S-k404/heater-driver-v4/reports/DRC_report.txt

** Drc report for heater_driver_v4.kicad_pcb **
** Created on 2026-10-17T09:11:54+0000 **
** Report includes: Errors, Warnings, Exclusions **

** Found 0 DRC violations **

** Found 0 unconnected pads **

** Found 0 Footprint errors **

** End of Report **
