S-k404/heater-driver-v4/docs/gerber_check_bottom.png

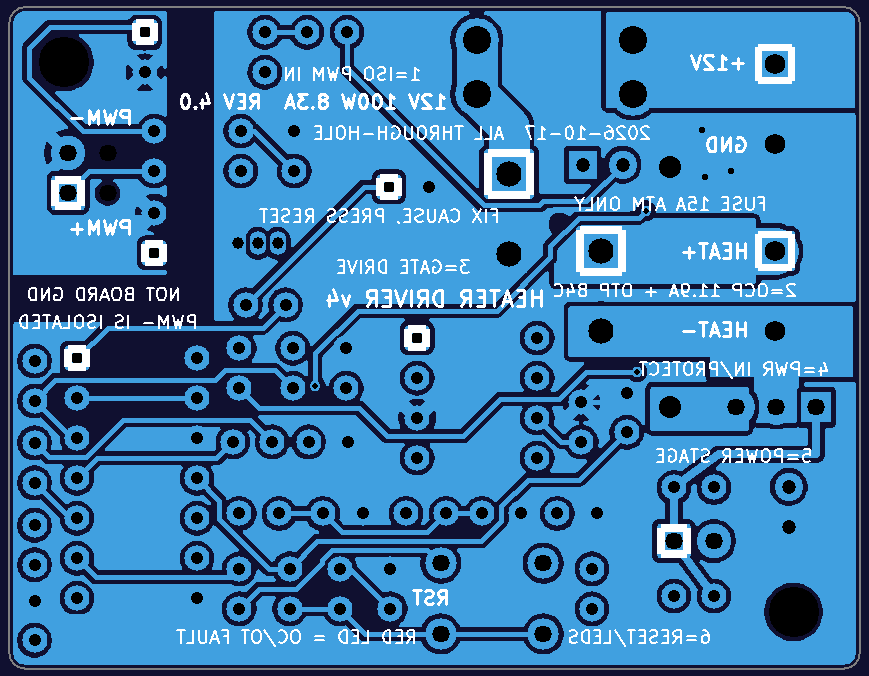
docs/gerber_check_bottom.png
