S-k404/heater-driver-v4/docs/gerber_check_top.png

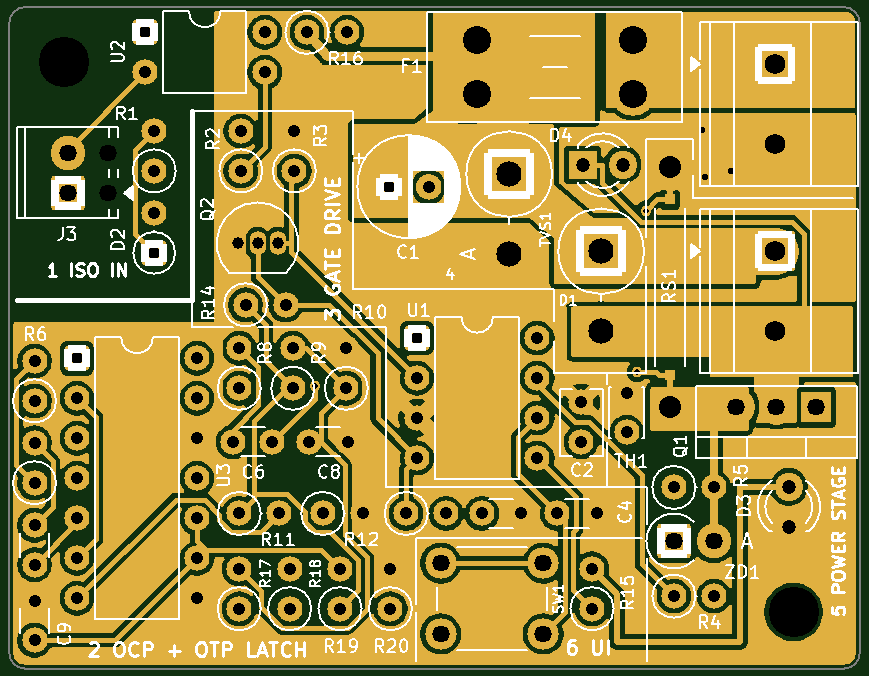
docs/gerber_check_top.png
