S-k404/heater-driver-v4/docs/heater_driver_v4_layout_bottom.png

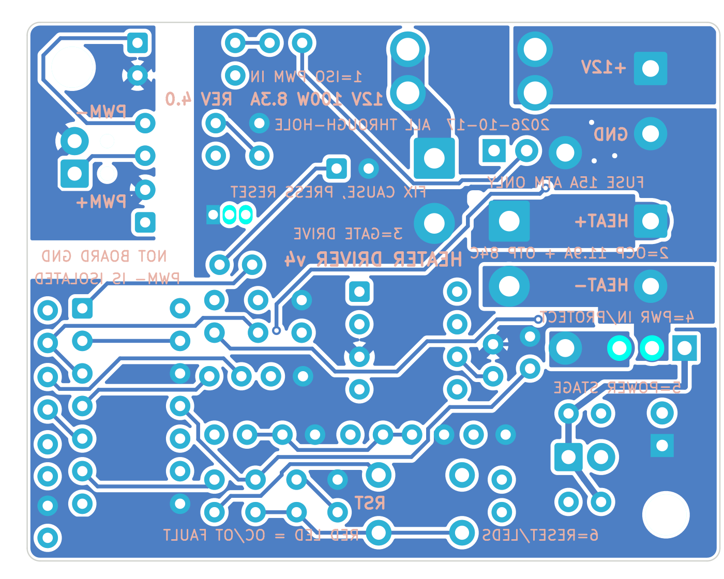
docs/heater_driver_v4_layout_bottom.png
