S-k404/heater-driver-v4/docs/heater_driver_v4_schematic.png

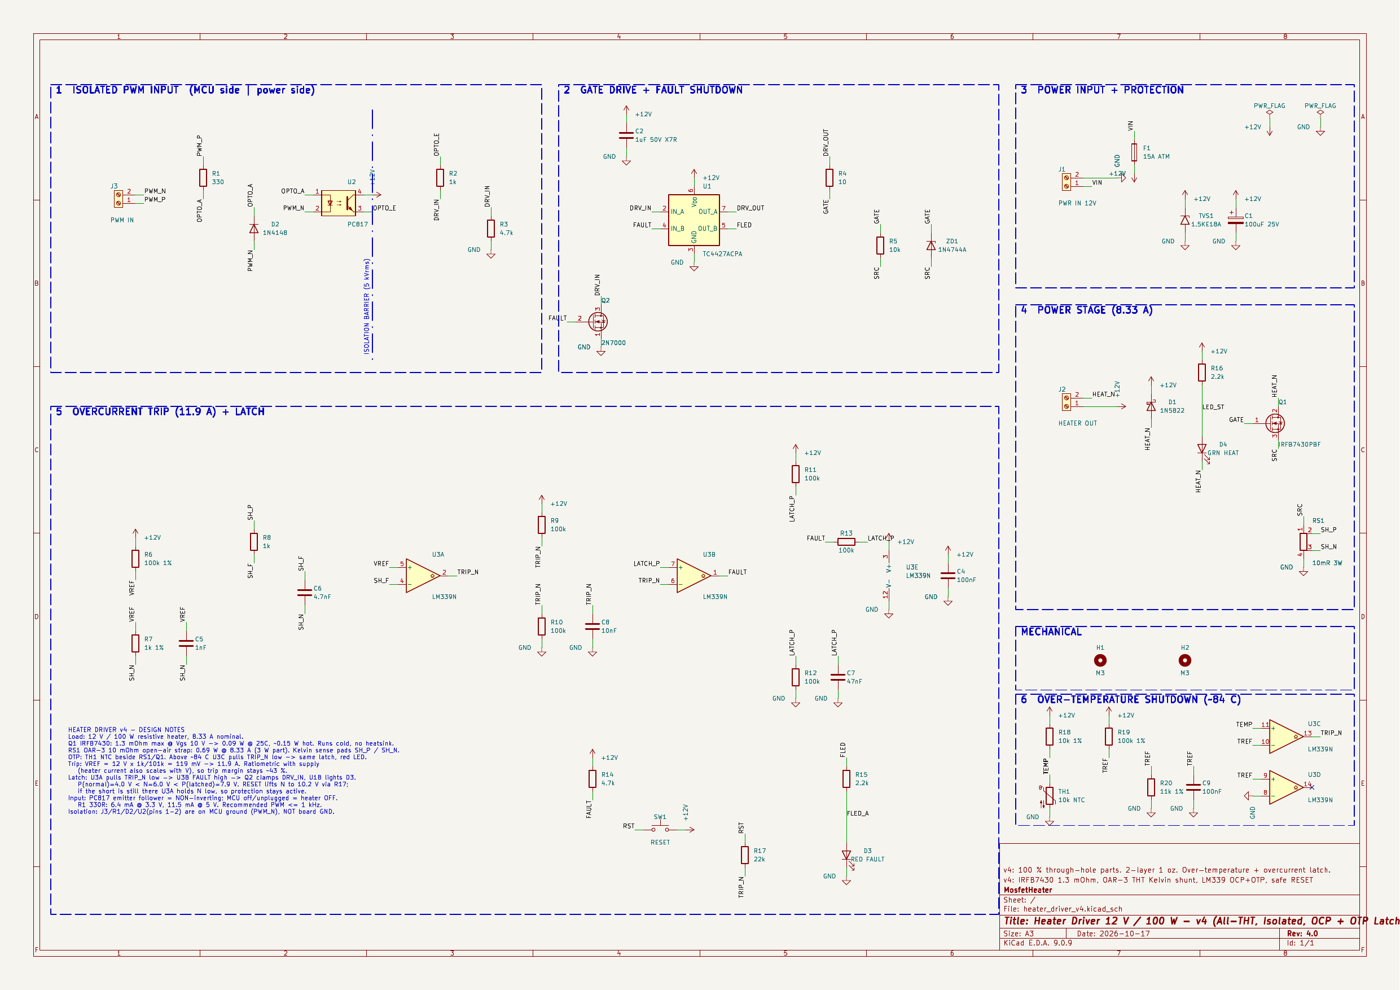
docs/heater_driver_v4_schematic.png
