S-k404/heater-driver-v4/sim/sim_overview.png

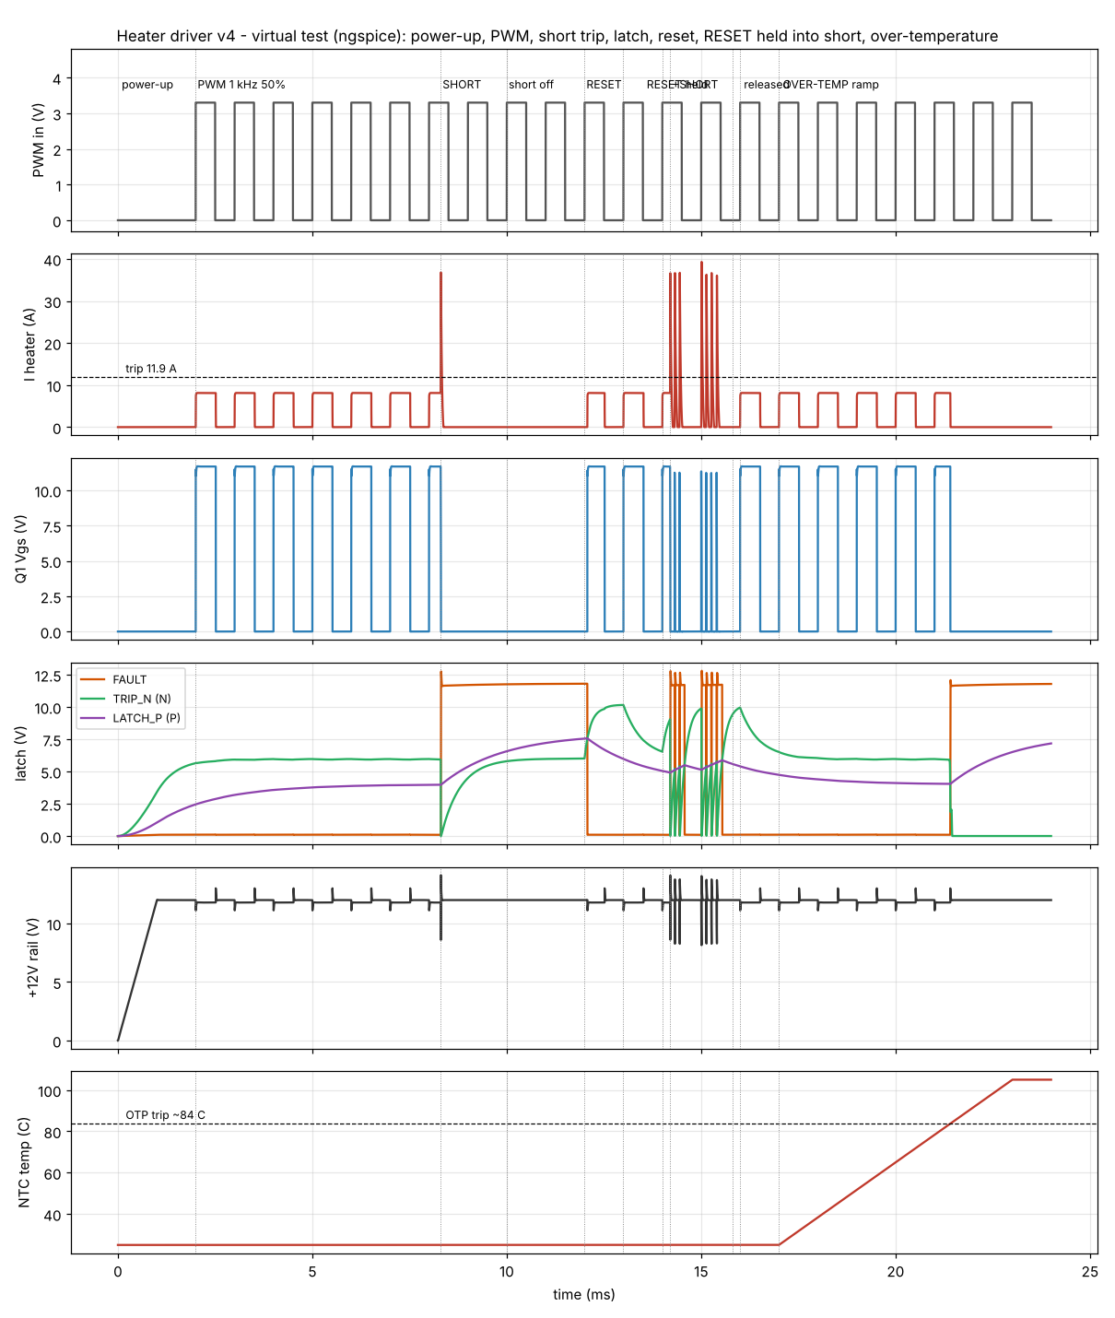
sim/sim_overview.png
