S-k404/heater-driver-v4/sim/sim_short_zoom.png

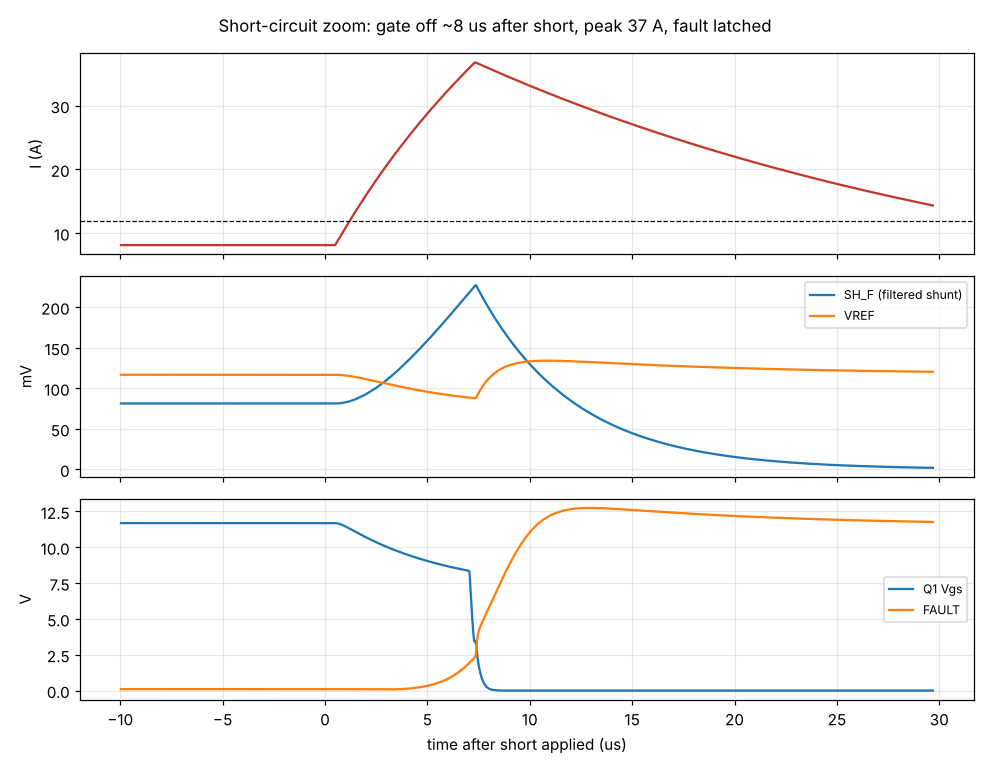
sim/sim_short_zoom.png
