S-k404/heater-driver-v4/bom/heater_driver_v4_BOM.csv

Reference | Value | Footprint | MPN | Description | Qty
C1 | 100uF 25V | Capacitor_THT:CP_Radial_D6.3mm_P2.50mm | Panasonic EEU-FR1E101 (low ESR, 6.3x11.2) | Bulk input capacitor | 1
C2 | 1uF 50V X7R | Capacitor_THT:C_Rect_L4.0mm_W2.5mm_P2.50mm | TDK FG28X7R1H105KRT06 | U1 decoupling (gate-charge reservoir) | 1
C4,C9 | 100nF | Capacitor_THT:C_Disc_D3.0mm_W1.6mm_P2.50mm | KEMET C320C104K5R5TA | Over-temp reference filter / soft start,U3 decoupling | 2
C5 | 1nF | Capacitor_THT:C_Disc_D3.0mm_W1.6mm_P2.50mm | KEMET C315C102K5R5TA | Reference HF filter | 1
C6 | 4.7nF | Capacitor_THT:C_Disc_D3.0mm_W1.6mm_P2.50mm | KEMET C315C472K5R5TA | Shunt sense filter C (4.7 us) | 1
C7 | 47nF | Capacitor_THT:C_Disc_D3.0mm_W1.6mm_P2.50mm | KEMET C320C473K5R5TA | Latch P timing / power-on reset (1.6 ms) | 1
C8 | 10nF | Capacitor_THT:C_Disc_D3.0mm_W1.6mm_P2.50mm | KEMET C315C103K5R5TA | Latch N timing (0.5 ms) | 1
D1 | 1N5822 | Diode_THT:D_DO-201AD_P5.08mm_Vertical_AnodeUp | onsemi 1N5822 | 40 V 3 A Schottky, heater flyback clamp | 1
D2 | 1N4148 | Diode_THT:D_DO-35_SOD27_P2.54mm_Vertical_AnodeUp | onsemi 1N4148 | Opto LED reverse-voltage protection | 1
D3 | RED FAULT | LED_THT:LED_D3.0mm | Kingbright WP7104ID | Red LED: overcurrent fault latched | 1
D4 | GRN HEAT | LED_THT:LED_D3.0mm | Kingbright WP7104GD | Green LED: heater ON | 1
F1 | 15A ATM | Fuse:Fuseholder_Blade_Mini_Keystone_3568 | Keystone 3568 + Littelfuse 0297015 (15A ATM) | Mini blade fuse holder + 15 A fuse | 1
J1 | PWR IN 12V | TerminalBlock_Phoenix:TerminalBlock_Phoenix_MKDS-1,5-2-5.08_1x02_P5.08mm_Horizontal | Phoenix 1729128 (MKDS 1,5/2-5,08, 13.5A) | Supply input screw terminal | 1
J2 | HEATER OUT | TerminalBlock_Phoenix:TerminalBlock_Phoenix_MKDS-1,5-2-5.08_1x02_P5.08mm_Horizontal | Phoenix 1729128 (MKDS 1,5/2-5,08, 13.5A) | Heater output screw terminal | 1
J3 | PWM IN | TerminalBlock_Phoenix:TerminalBlock_Phoenix_MPT-0,5-2-2.54_1x02_P2.54mm_Horizontal | Phoenix 1725656 (MPT 0,5/2-2,54) | Isolated PWM input (3.3-5 V logic) | 1
Q1 | IRFB7430PBF | Package_TO_SOT_THT:TO-220-3_Vertical | Infineon IRFB7430PBF (alt: IRLB3034PBF) | 40 V 195 A 1.3 mOhm N-MOSFET, low-side switch (~0.1 W at 8.3 A) | 1
Q2 | 2N7000 | Package_TO_SOT_THT:TO-92_Inline | onsemi 2N7000 | Fault shutdown: pulls driver input low | 1
R1 | 330 | Resistor_THT:R_Axial_DIN0207_L6.3mm_D2.5mm_P2.54mm_Vertical | Yageo MFR-25FBF52-330R | Opto LED current limit (6-11 mA) | 1
R2,R8 | 1k | Resistor_THT:R_Axial_DIN0207_L6.3mm_D2.5mm_P2.54mm_Vertical | Yageo MFR-25FBF52-1K | Opto emitter series resistor,Shunt sense filter R | 2
R3,R14 | 4.7k | Resistor_THT:R_Axial_DIN0207_L6.3mm_D2.5mm_P2.54mm_Vertical | Yageo MFR-25FBF52-4K7 | Driver input pull-down (fail-safe OFF),FAULT pull-up | 2
R4 | 10 | Resistor_THT:R_Axial_DIN0207_L6.3mm_D2.5mm_P2.54mm_Vertical | Yageo MFR-25FBF52-10R | Gate resistor | 1
R5 | 10k | Resistor_THT:R_Axial_DIN0207_L6.3mm_D2.5mm_P2.54mm_Vertical | Yageo MFR-25FBF52-10K | Gate-source pull-down | 1
R6,R19 | 100k 1% | Resistor_THT:R_Axial_DIN0207_L6.3mm_D2.5mm_P2.54mm_Vertical | Yageo MFR-25FBF52-100K | Over-temp reference divider (top),Trip reference divider (top) | 2
R7 | 1k 1% | Resistor_THT:R_Axial_DIN0207_L6.3mm_D2.5mm_P2.54mm_Vertical | Yageo MFR-25FBF52-1K | Trip reference divider (bottom): 119 mV = 11.9 A | 1
R9-R13 | 100k | Resistor_THT:R_Axial_DIN0207_L6.3mm_D2.5mm_P2.54mm_Vertical | Yageo MFR-25FBF52-100K | Latch P divider (bottom),Latch P divider (top),Latch positive feedback,Latch threshold divider (bottom),Latch threshold divider (top), N = 6 V | 5
R15,R16 | 2.2k | Resistor_THT:R_Axial_DIN0207_L6.3mm_D2.5mm_P2.54mm_Vertical | Yageo MFR-25FBF52-2K2 | FAULT LED resistor,HEAT ON LED resistor | 2
R17 | 22k | Resistor_THT:R_Axial_DIN0207_L6.3mm_D2.5mm_P2.54mm_Vertical | Yageo MFR-25FBF52-22K | Reset injection resistor: protection stays active while RESET is held | 1
R18 | 10k 1% | Resistor_THT:R_Axial_DIN0207_L6.3mm_D2.5mm_P2.54mm_Vertical | Yageo MFR-25FBF52-10K | NTC divider top | 1
R20 | 11k 1% | Resistor_THT:R_Axial_DIN0207_L6.3mm_D2.5mm_P2.54mm_Vertical | Yageo MFR-25FBF52-11K | Over-temp reference divider (bottom): 1.19 V = NTC 1.1k = ~84 C | 1
RS1 | 10mR 3W | HeaterDriver:R_Shunt_OAR3_P15.24mm_Kelvin | TT Electronics/IRC OAR3R010FLF | 10 mOhm 1% 3 W open-air THT current shunt, Kelvin sense pads | 1
SW1 | RESET | Button_Switch_THT:SW_PUSH_6mm | Omron B3F-1000 | Fault reset push-button (lifts TRIP_N above LATCH_P) | 1
TH1 | 10k NTC | Capacitor_THT:C_Disc_D3.0mm_W2.0mm_P2.50mm | Vishay NTCLE100E3103JB0 | NTC 10 k @25 C, B=3977: over-temperature sensor beside RS1/Q1 | 1
TVS1 | 1.5KE18A | Diode_THT:D_DO-201AD_P5.08mm_Vertical_AnodeUp | Littelfuse 1.5KE18A | 1500 W TVS, 15.3 V standoff | 1
U1 | TC4427ACPA | Package_DIP:DIP-8_W7.62mm | Microchip TC4427ACPA (DIP-8) | 1.5 A dual non-inverting MOSFET driver (A=gate, B=fault LED) | 1
U2 | PC817 | Package_DIP:DIP-4_W7.62mm | Sharp PC817X / Everlight EL817 | 5 kVrms optocoupler, non-inverting emitter-follower | 1
U3 | LM339N | Package_DIP:DIP-14_W7.62mm | TI LM339N (DIP-14) | Quad comparator: A=11.9 A trip, B=latch, C=over-temperature, D=spare | 1
ZD1 | 1N4744A | Diode_THT:D_DO-41_SOD81_P2.54mm_Vertical_AnodeUp | onsemi 1N4744A | 15 V 1 W zener gate clamp | 1
