S-k404/heater-driver-v4/docs/heater_driver_v4_schematic.pdf

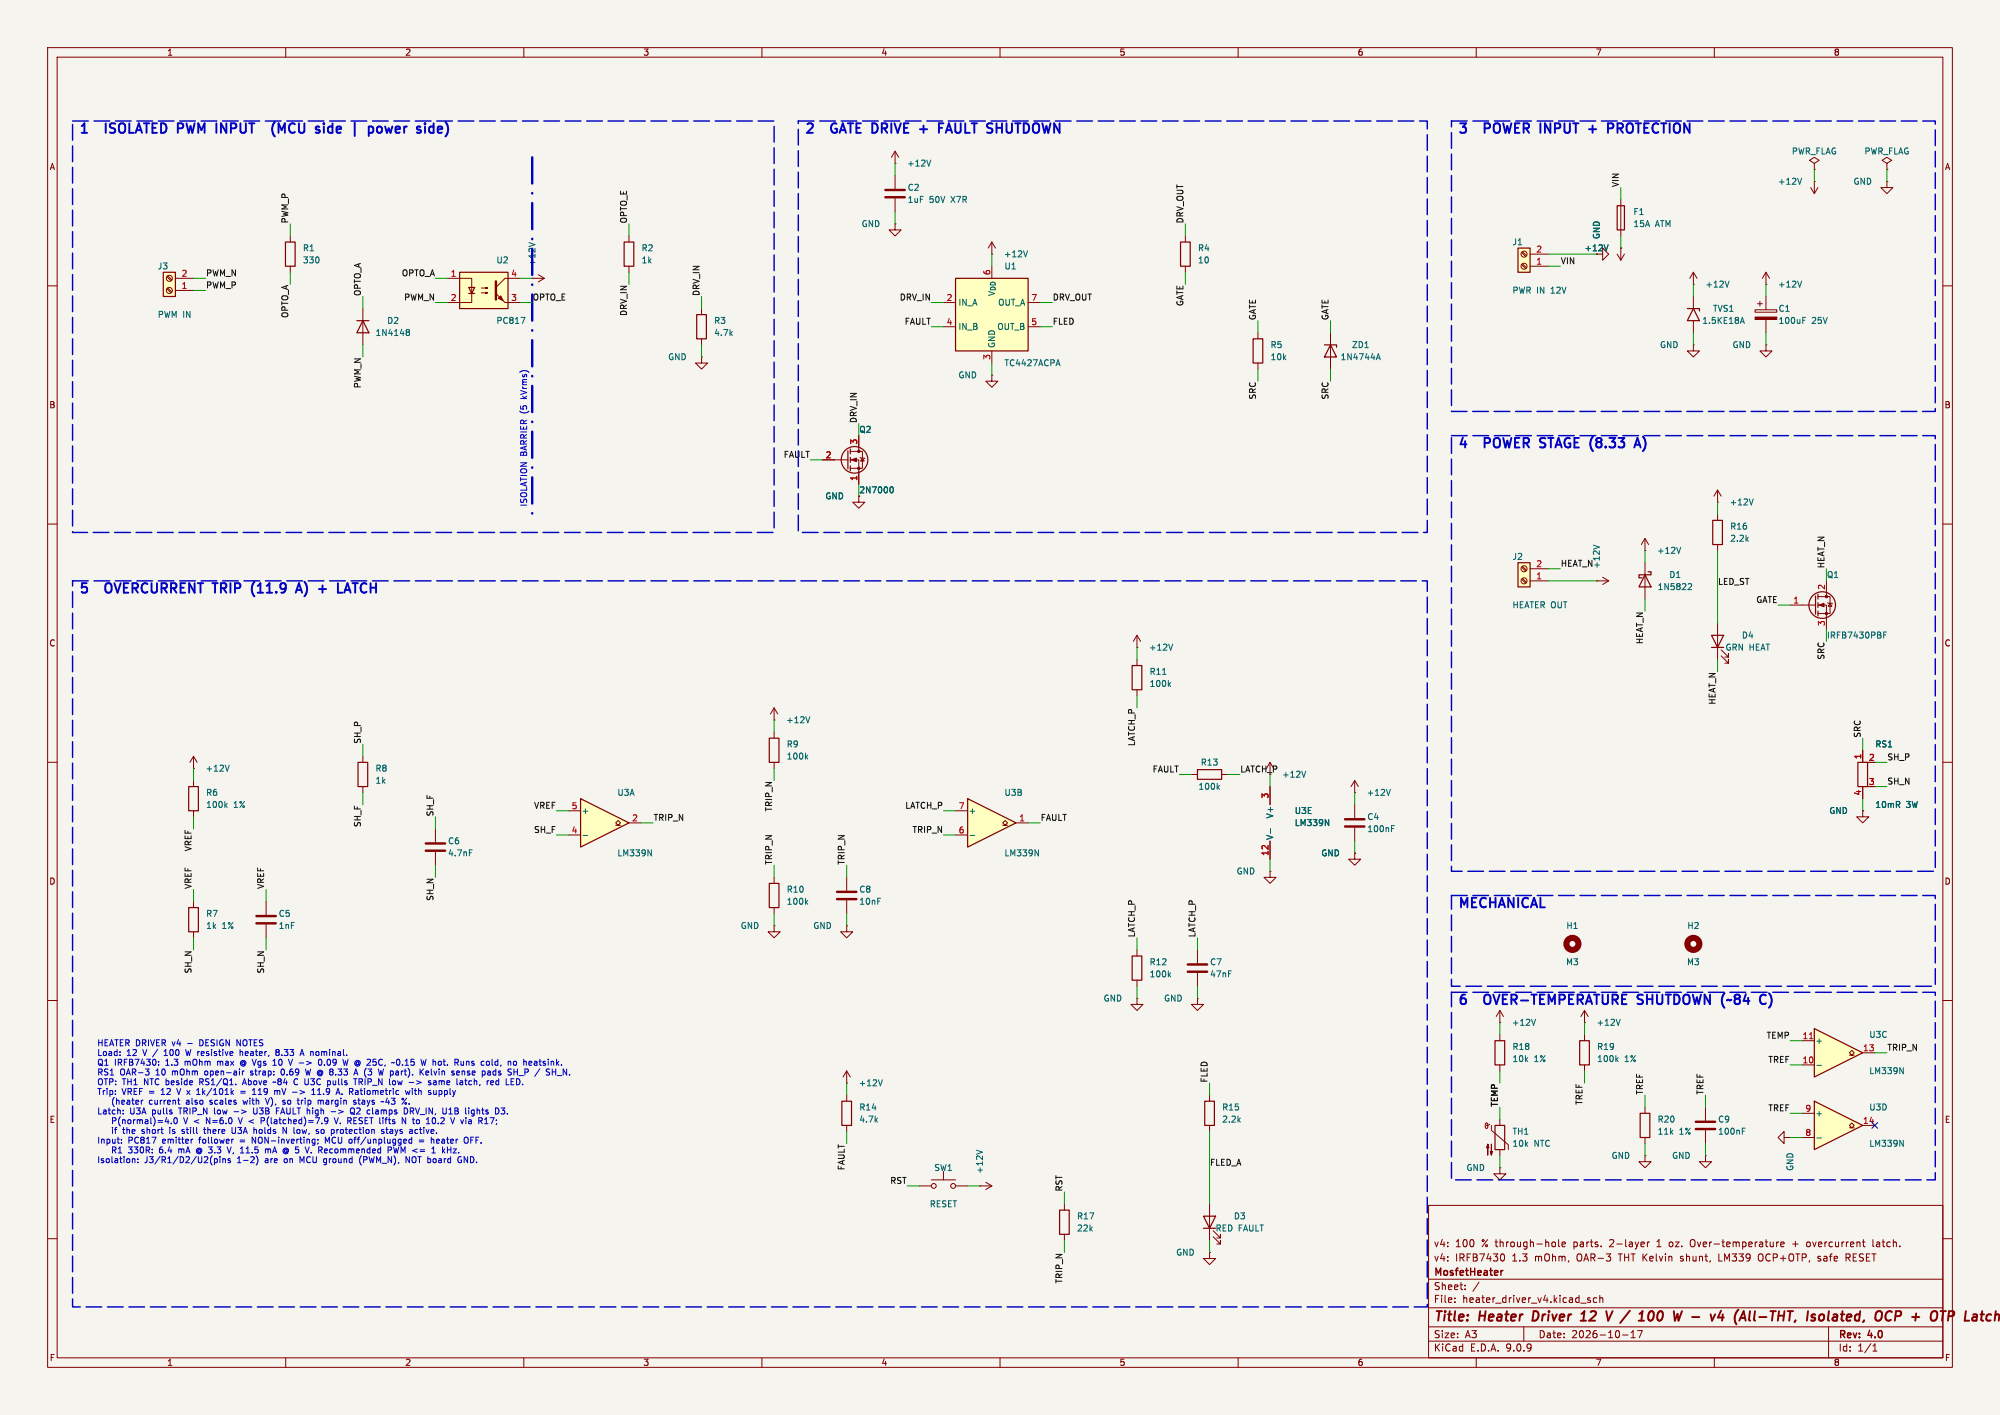
[picture p13: page 1]

HEATER DRIVER v4 - DESIGN NOTES
