S-k404/heater-driver-v4/docs/heater_driver_v4_layout.pdf

1 | 2 | 3 | 4 | 5 | 6

A

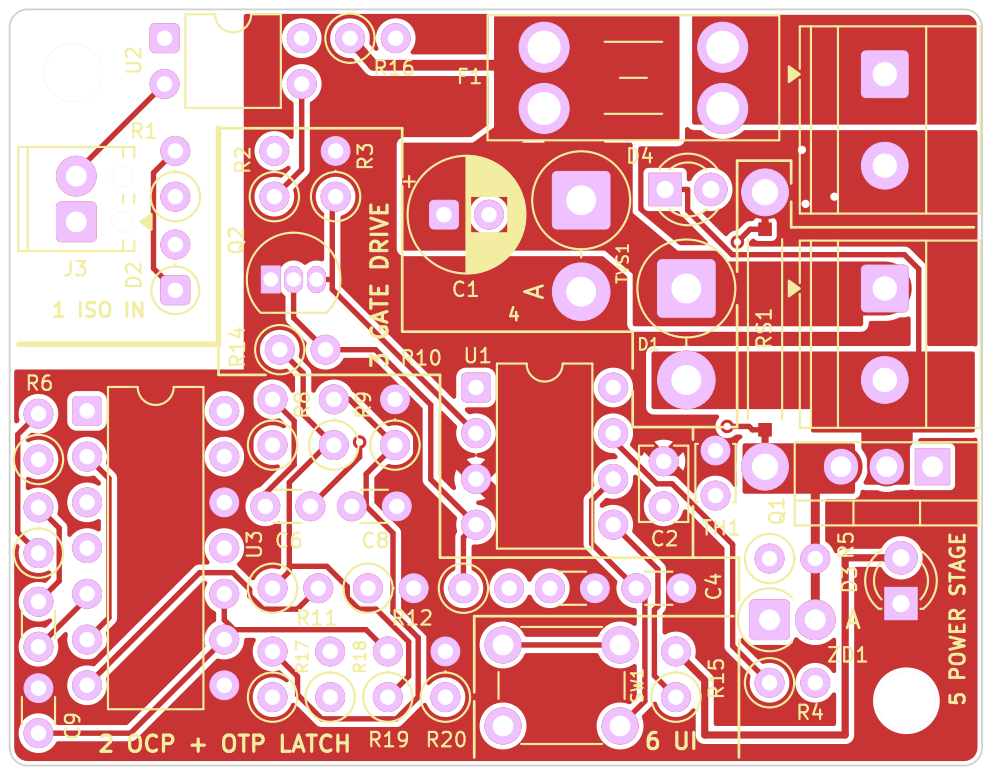
[picture p14: page 1]

Id: 1/1 Title: File: heater_driver_v4.kicad_pcb Sheet:

A

A

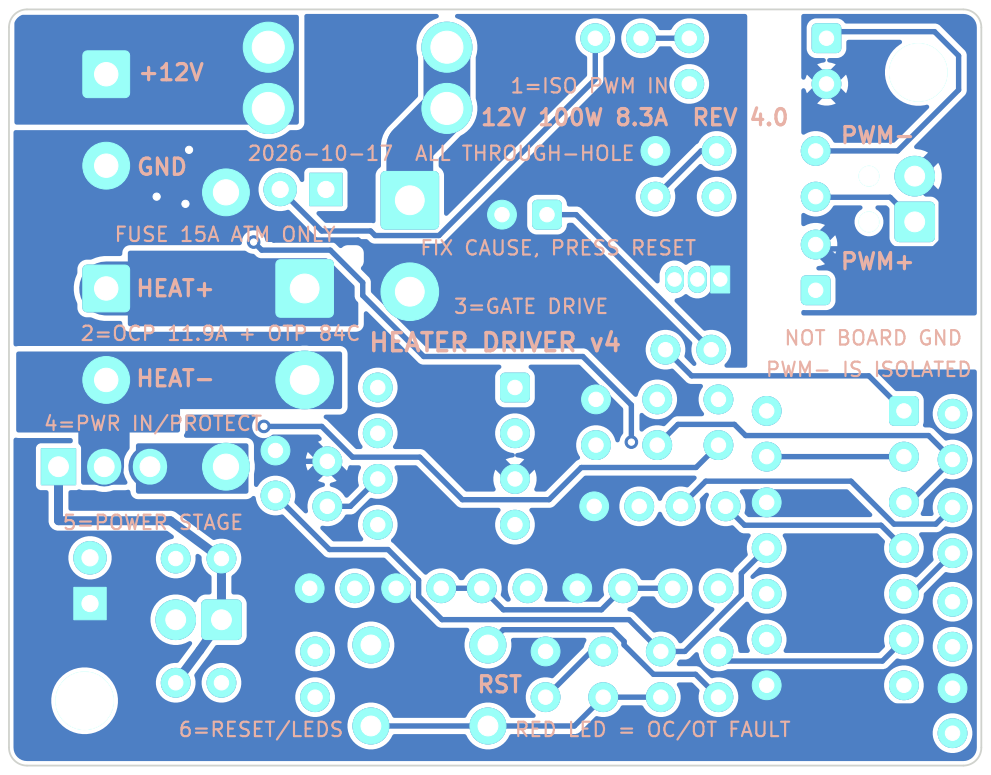
[picture p15: page 2]
D Date: KiCad; E.D.A. 9.0.9 Size: A4; Rev:; 3=GATE DRIVE; ALL THROUGH-HOLE; 6=RESET/LEDS; 2=OCP 11.9A + OTP 84C; 5=POWER STAGE; PWM- PWM+; REV 4.0 RST HEAT+ HEAT- +12V GND; HEATER DRIVER v4

1=ISO PWM IN

FUSE 15A ATM ONLY

FIX CAUSE, PRESS RESET

NOT BOARD GND
PWM- IS ISOLATED

4=PWR IN/PROTECT

RED LED = OC/OT FAULT

Id: 1/1 Title: File: heater_driver_v4.kicad_pcb Sheet:

A

A

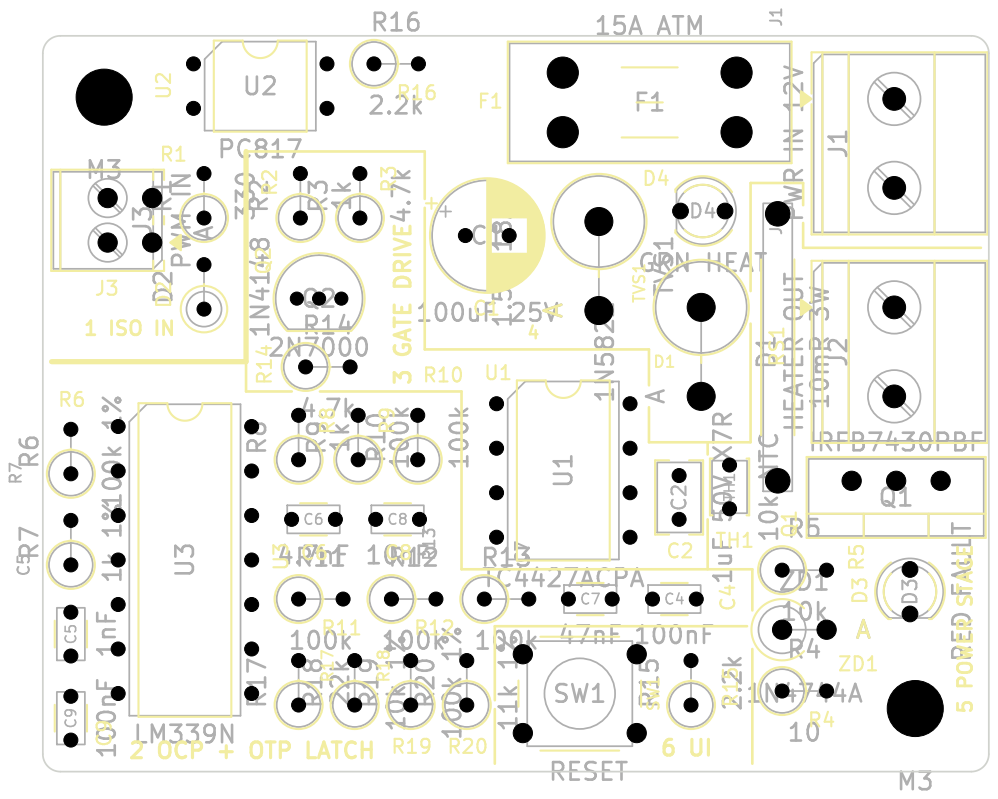
[picture p16: page 3]

Id: 1/1 Title: File: heater_driver_v4.kicad_pcb Sheet:
