S-k404/heater-driver-v4/heater_driver_v4.kicad_pcb

## KiCad design heater_driver_v4.kicad_pcb (2026-11-08)

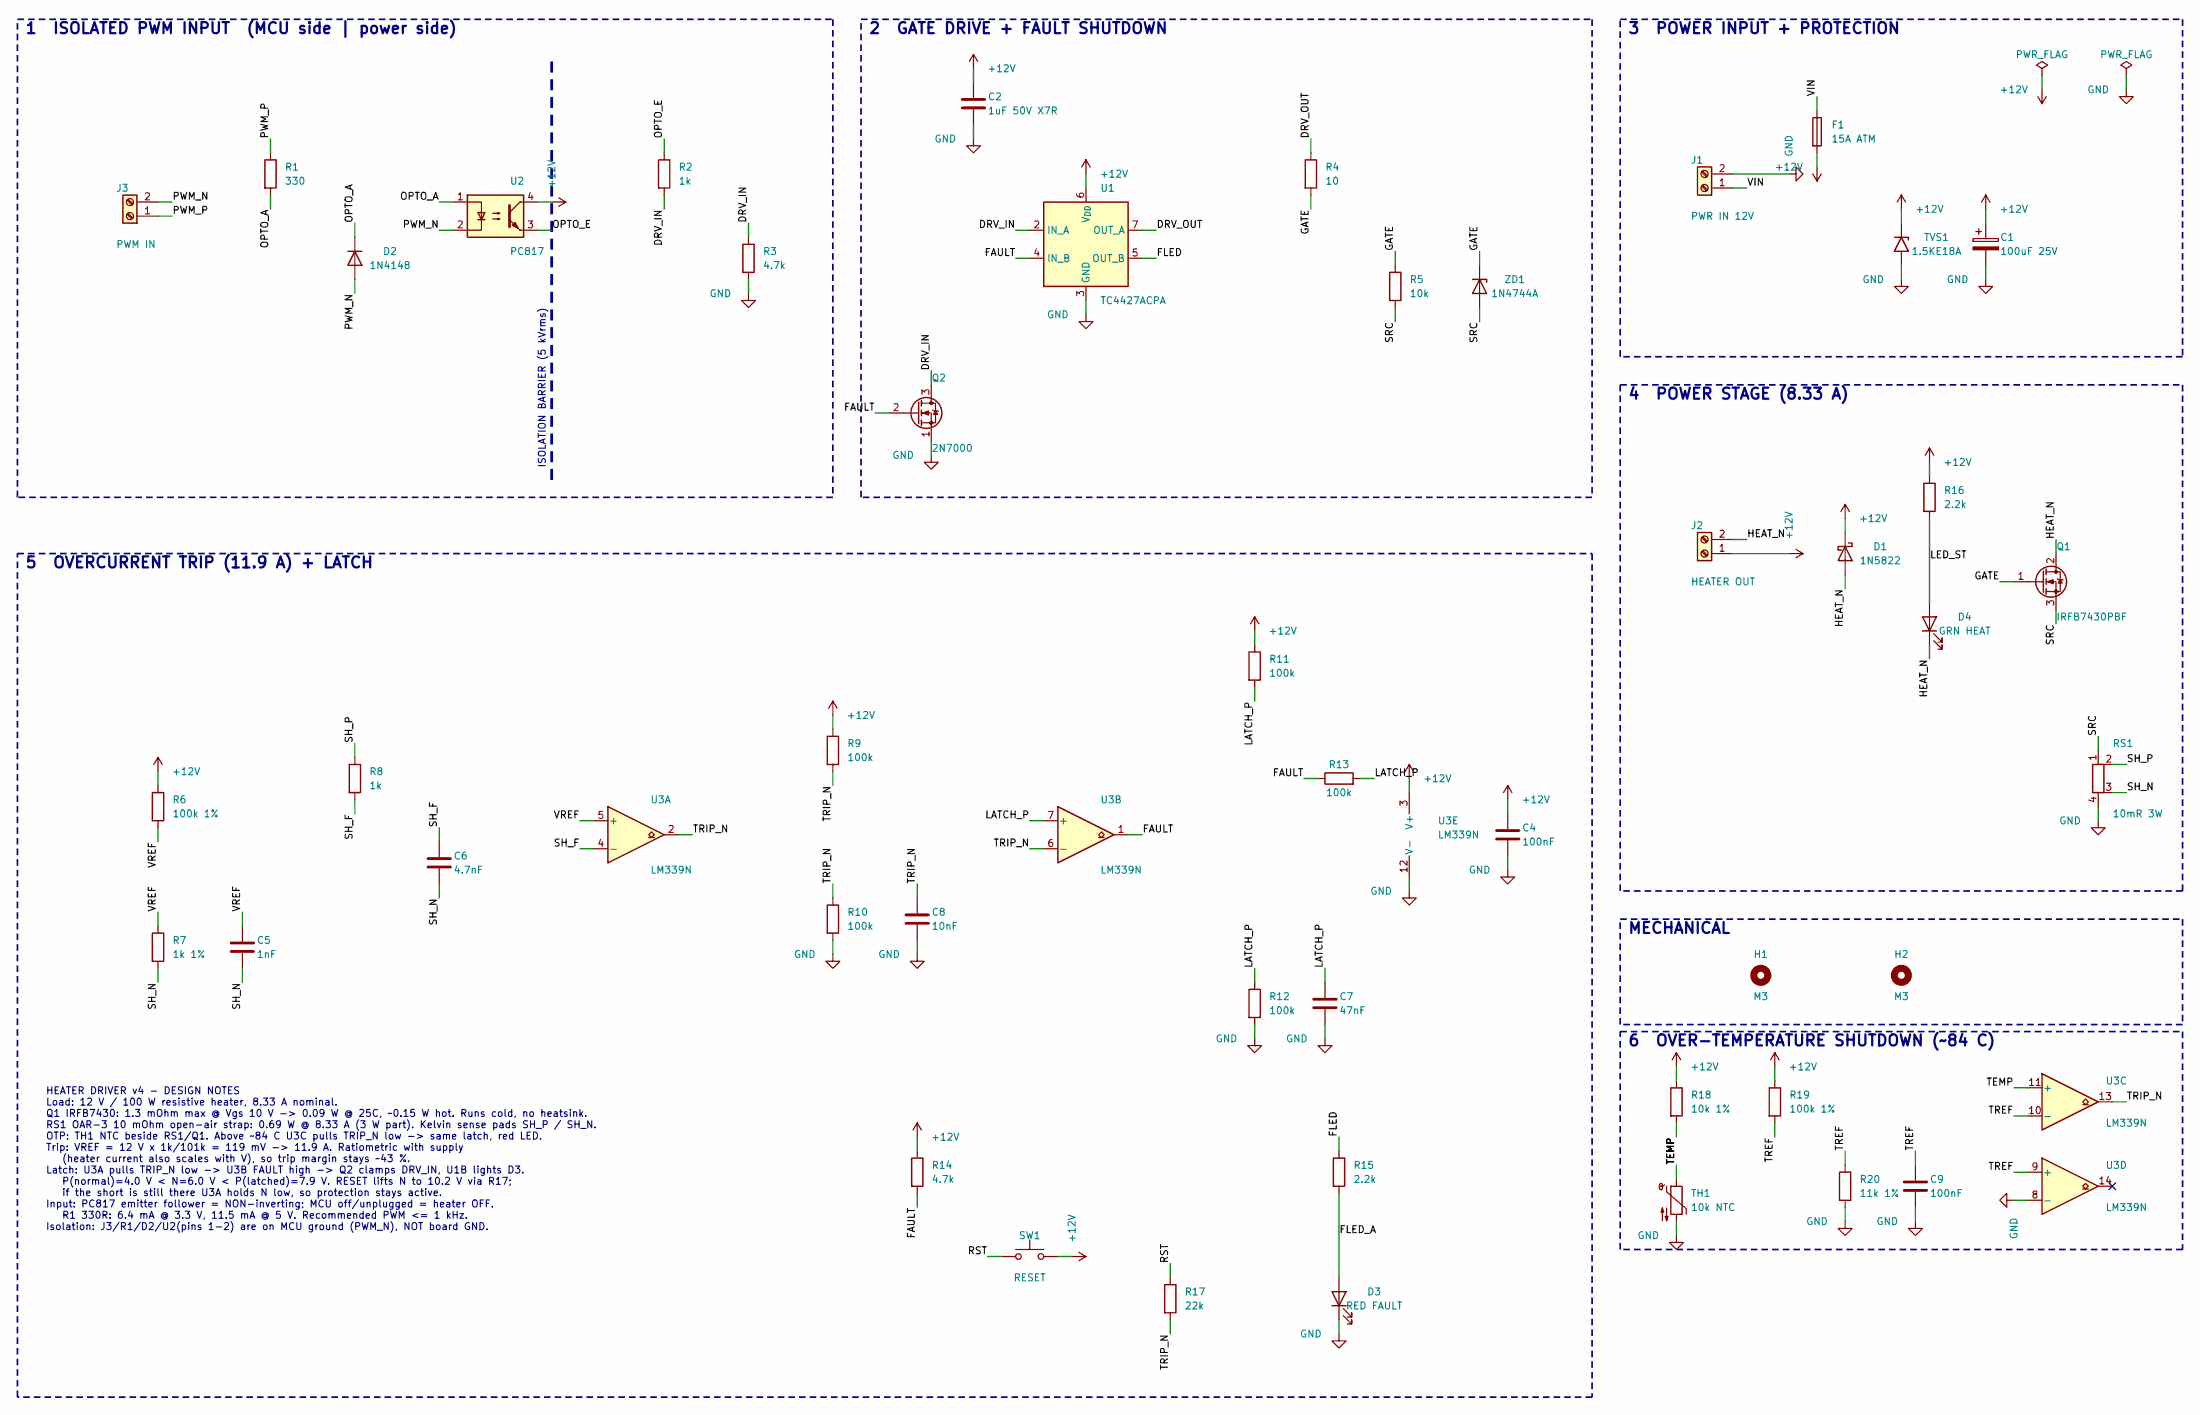
[picture p17: schematic heater_driver_v4.kicad_sch, Heater Driver 12 V / 100 W - v4 (All-THT, Isolated, OCP + O…]

Parts:
C1: 100uF 25V; CP_Radial_D6.3mm_P2.50mm; MPN Panasonic EEU-FR1E101 (low ESR, 6.3x11.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
C2: 1uF 50V X7R; C_Rect_L4.0mm_W2.5mm_P2.50mm; MPN TDK FG28X7R1H105KRT06
C4, C9: 100nF; C_Disc_D3.0mm_W1.6mm_P2.50mm; MPN KEMET C320C104K5R5TA
C5: 1nF; C_Disc_D3.0mm_W1.6mm_P2.50mm; MPN KEMET C315C102K5R5TA
C6: 4.7nF; C_Disc_D3.0mm_W1.6mm_P2.50mm; MPN KEMET C315C472K5R5TA
C7: 47nF; C_Disc_D3.0mm_W1.6mm_P2.50mm; MPN KEMET C320C473K5R5TA
C8: 10nF; C_Disc_D3.0mm_W1.6mm_P2.50mm; MPN KEMET C315C103K5R5TA
D1: 1N5822; D_DO-201AD_P5.08mm_Vertical_AnodeUp; MPN onsemi 1N5822
D2: 1N4148; D_DO-35_SOD27_P2.54mm_Vertical_AnodeUp; MPN onsemi 1N4148
D3: RED FAULT; LED_D3.0mm; MPN Kingbright WP7104ID
D4: GRN HEAT; LED_D3.0mm; MPN Kingbright WP7104GD
F1: 15A ATM; Fuseholder_Blade_Mini_Keystone_3568; MPN Keystone 3568 + Littelfuse 0297015 (15A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
H1, H2: M3; MountingHole_3.2mm_M3
J1: PWR IN 12V; TerminalBlock_Phoenix_MKDS-1,5-2-5.08_1x02_P5.08mm_Horizont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; MPN Phoenix 1729128 (MKDS 1,5/2-5,08, 13.5A)
J2: HEATER OUT; TerminalBlock_Phoenix_MKDS-1,5-2-5.08_1x02_P5.08mm_Horizont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; MPN Phoenix 1729128 (MKDS 1,5/2-5,08, 13.5A)
J3: PWM IN; TerminalBlock_Phoenix_MPT-0,5-2-2.54_1x02_P2.54mm_Horizontal; MPN Phoenix 1725656 (MPT 0,5/2-2,54)
Q1: IRFB7430PBF; TO-220-3_Vertical; MPN Infineon IRFB7430PBF (alt: IRLB3034PBF)
Q2: 2N7000; TO-92_Inline; MPN onsemi 2N7000
R1: 330; R_Axial_DIN0207_L6.3mm_D2.5mm_P2.54mm_Vertical; MPN Yageo MFR-25FBF52-330R
R2, R8: 1k; R_Axial_DIN0207_L6.3mm_D2.5mm_P2.54mm_Vertical; MPN Yageo MFR-25FBF52-1K
R3, R14: 4.7k; R_Axial_DIN0207_L6.3mm_D2.5mm_P2.54mm_Vertical; MPN Yageo MFR-25FBF52-4K7
R4: 10; R_Axial_DIN0207_L6.3mm_D2.5mm_P2.54mm_Vertical; MPN Yageo MFR-25FBF52-10R
R5: 10k; R_Axial_DIN0207_L6.3mm_D2.5mm_P2.54mm_Vertical; MPN Yageo MFR-25FBF52-10K
R6, R19: 100k 1%; R_Axial_DIN0207_L6.3mm_D2.5mm_P2.54mm_Vertical; MPN Yageo MFR-25FBF52-100K
R7: 1k 1%; R_Axial_DIN0207_L6.3mm_D2.5mm_P2.54mm_Vertical; MPN Yageo MFR-25FBF52-1K
R9, R10, R11, R12, R13: 100k; R_Axial_DIN0207_L6.3mm_D2.5mm_P2.54mm_Vertical; MPN Yageo MFR-25FBF52-100K
R15, R16: 2.2k; R_Axial_DIN0207_L6.3mm_D2.5mm_P2.54mm_Vertical; MPN Yageo MFR-25FBF52-2K2
R17: 22k; R_Axial_DIN0207_L6.3mm_D2.5mm_P2.54mm_Vertical; MPN Yageo MFR-25FBF52-22K
R18: 10k 1%; R_Axial_DIN0207_L6.3mm_D2.5mm_P2.54mm_Vertical; MPN Yageo MFR-25FBF52-10K
R20: 11k 1%; R_Axial_DIN0207_L6.3mm_D2.5mm_P2.54mm_Vertical; MPN Yageo MFR-25FBF52-11K
RS1: 10mR 3W; R_Shunt_OAR3_P15.24mm_Kelvin; MPN TT Electronics/IRC OAR3R010FLF
SW1: RESET; SW_PUSH_6mm; MPN Omron B3F-1000
TH1: 10k NTC; C_Disc_D3.0mm_W2.0mm_P2.50mm; MPN Vishay NTCLE100E3103JB0
TVS1: 1.5KE18A; D_DO-201AD_P5.08mm_Vertical_AnodeUp; MPN Littelfuse 1.5KE18A
U1: TC4427ACPA; DIP-8_W7.62mm; MPN Microchip TC4427ACPA (DIP-8)
U2: PC817; DIP-4_W7.62mm; MPN Sharp PC817X / Everlight EL817
U3: LM339N; DIP-14_W7.62mm; MPN TI LM339N (DIP-14)
ZD1: 1N4744A; D_DO-41_SOD81_P2.54mm_Vertical_AnodeUp; MPN onsemi 1N4744A

Connections:
+12V: C1.1, C2.1, C4.1, D1.1 (K), F1.2, J2.1, R6.1, R9.1, R11.1, R14.1, R16.1, R18.1, R19.1, SW1.2, TVS1.1 (A1), U1.6 (V_{DD}), U2.4, U3.3 (V+)
/DRV_IN: Q2.3 (D), R2.2, R3.1, U1.2 (IN_A)
/DRV_OUT: R4.1, U1.7 (OUT_A)
/FAULT: Q2.2 (G), R13.1, R14.2, U1.4 (IN_B), U3.1
/FLED: R15.1, U1.5 (OUT_B)
/FLED_A: D3.2 (A), R15.2
/GATE: Q1.1 (G), R4.2, R5.1, ZD1.1 (K)
/HEAT_N: D1.2 (A), D4.1 (K), J2.2, Q1.2 (D)
/LATCH_P: C7.1, R11.2, R12.1, R13.2, U3.7 (+)
/LED_ST: D4.2 (A), R16.2
/OPTO_A: D2.1 (K), R1.2, U2.1
/OPTO_E: R2.1, U2.3
/PWM_N: D2.2 (A), J3.2, U2.2
/PWM_P: J3.1, R1.1
/RST: R17.1, SW1.1
/SH_F: C6.1, R8.2, U3.4 (-)
/SH_N: C5.2, C6.2, R7.2, RS1.3
/SH_P: R8.1, RS1.2
/SRC: Q1.3 (S), R5.2, RS1.1, ZD1.2 (A)
/TEMP: R18.2, TH1.1, U3.11 (+)
/TREF: C9.1, R19.2, R20.1, U3.9 (+), U3.10 (-)
/TRIP_N: C8.1, R9.2, R10.1, R17.2, U3.2, U3.6 (-), U3.13
/VIN: F1.1, J1.1
/VREF: C5.1, R6.2, R7.1, U3.5 (+)
GND: C1.2, C2.2, C4.2, C7.2, C8.2, C9.2, D3.1 (K), J1.2, Q2.1 (S), R3.2, R10.2, R12.2, R20.2, RS1.4, TH1.2, TVS1.2 (A2), U1.3 (GND), U3.8 (-), U3.12 (V-)

Notes on the sheet:
1 ISOLATED PWM INPUT (MCU side | power side)
2 GATE DRIVE + FAULT SHUTDOWN
3 POWER INPUT + PROTECTION
4 POWER STAGE (8.33 A)
5 OVERCURRENT TRIP (11.9 A) + LATCH
MECHANICAL
6 OVER-TEMPERATURE SHUTDOWN (~84 C)
ISOLATION BARRIER (5 kVrms)
HEATER DRIVER v4 - DESIGN NOTES Load: 12 V / 100 W resistive heater, 8.33 A nominal. Q1 IRFB7430: 1.3 mOhm max @ Vgs 10 V -> 0.09 W @ 25C, ~0.15 W hot. Runs cold, no heatsink. RS1 OAR-3 10 mOhm open-air strap: 0.69 W @ 8.33 A (3 W part). Kelvin sense pads SH_P / SH_N. OTP: TH1 NTC beside RS1/Q1. Ab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

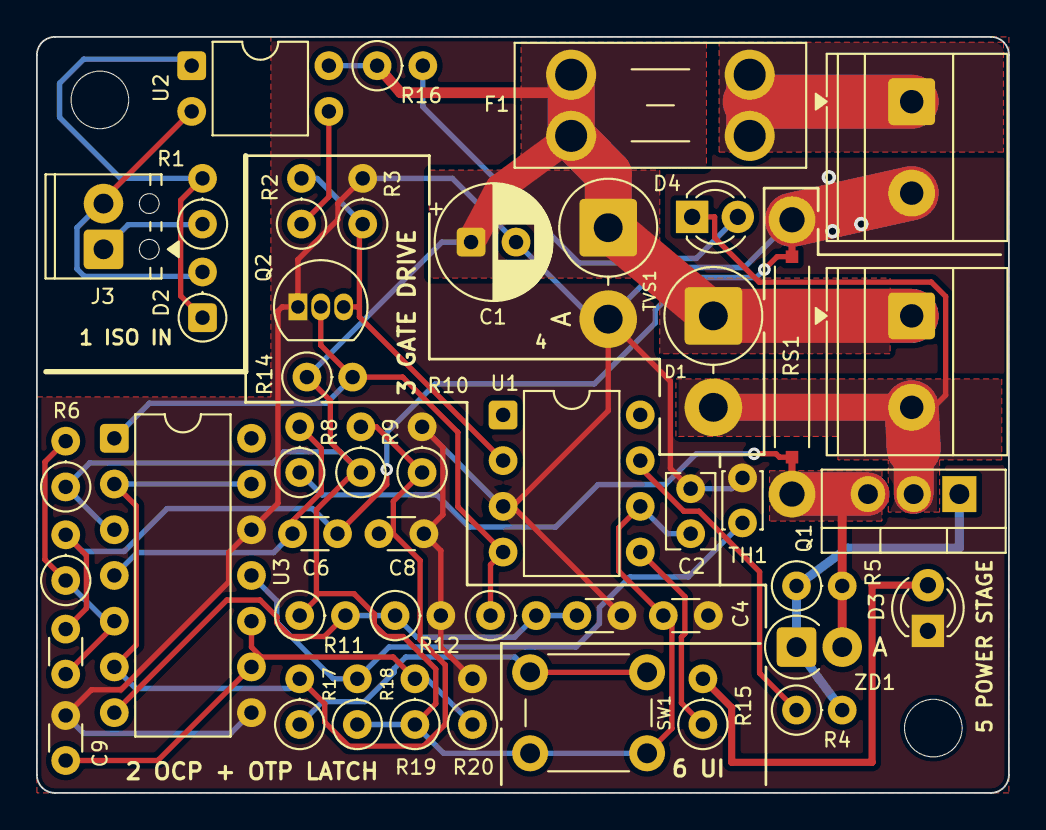
[picture p18: board heater_driver_v4.kicad_pcb from above]

Board: 2 copper layers, 54.0 x 42.0 mm, 48 parts (0 on the bottom side), 25 nets.
